Qeteshpony/displaytronic/flipdot board/README.md

Revere engineered from the original board. Some parts are simplified and just show the logic. 

This is NOT a complete schematics drawing.
