Qeteshpony/displaytronic/CHANGELOG.md

# Changelog

## [1.0.1](https://github.com/Qeteshpony/displaytronic/compare/v1.0.0...v1.0.1) (2026-11-11)

### Bug Fixes

* **pcb:** wrong part number for 2 resistors ([9722948](https://github.com/Qeteshpony/displaytronic/commit/9722948e23da16186d39c03120288686e7f75a20))

## 1.0.0 (2026-11-10)

### Features

* **firmware:** add debugging over UART ([d42d1d6](https://github.com/Qeteshpony/displaytronic/commit/d42d1d64cf81c9214dd820a91fe4b76d763d3ecf))
* **firmware:** add flipdot driver ([967017e](https://github.com/Qeteshpony/displaytronic/commit/967017ec6ec610487fccee4e81757cec2f1832d0))
* **firmware:** add watchdog ([05a6637](https://github.com/Qeteshpony/displaytronic/commit/05a66375ccd68013d24e9db8baa855eb8dae2f2b))
* **firmware:** i2c interface ([2d1449f](https://github.com/Qeteshpony/displaytronic/commit/2d1449f2643044d9899a1bcff528ac561d937caa))
* **firmware:** light control ([0a22b43](https://github.com/Qeteshpony/displaytronic/commit/0a22b433b96bafc5785d298e5330ff81d1ff8ec4))
* **firmware:** status led ([9a84e4e](https://github.com/Qeteshpony/displaytronic/commit/9a84e4e517a992f0ab90c25b8353c08e9bccb6c8))
* **firmware:** version variables ([1e22f5d](https://github.com/Qeteshpony/displaytronic/commit/1e22f5d5b68a2e35fe8b67fa83a54d46f8ed88af))
* **firmware:** voltage sensors ([f075a49](https://github.com/Qeteshpony/displaytronic/commit/f075a49cf83af12c4e1e7ecaf647c56542b67ade))
* **pcb:** add pulse length limiter ([4bc0cde](https://github.com/Qeteshpony/displaytronic/commit/4bc0cdea27e73a1a9573296e2052f03f9e7936c4))
* **pcb:** add test points for some measurements ([2fb60d9](https://github.com/Qeteshpony/displaytronic/commit/2fb60d90d1a6a19221fe2e596b67342964169248))

### Bug Fixes

* **firmware:** add line break after debug messages ([049d4a1](https://github.com/Qeteshpony/displaytronic/commit/049d4a1bdcdabd539bb84be48b84d3c564b92f33))
* **firmware:** missing check ([3f58c2e](https://github.com/Qeteshpony/displaytronic/commit/3f58c2e17abb0dd11ff050c7f13f776b6e84d881))
* **firmware:** wrong variable type ([972ce3d](https://github.com/Qeteshpony/displaytronic/commit/972ce3dc0bdc4f2c249ff911073fc927c013a0ef))
* **firmware:** wrong variable type ([5a82e2e](https://github.com/Qeteshpony/displaytronic/commit/5a82e2e93db4aff974e40ec310347f2e365a50d5))
* **pcb:** add flyback diodes to row drivers ([ad231c8](https://github.com/Qeteshpony/displaytronic/commit/ad231c836e0294169ef6a69e5529e9fcd01c4730))
* **pcb:** reduce high-side gate resistor values for faster switching ([8dd9e66](https://github.com/Qeteshpony/displaytronic/commit/8dd9e664ee31bba52ffd4d5f429f1cfb8b86b1ce))
