Qeteshpony/displaytronic/pcb/displaytronic.kicad_pcb

## KiCad design pcb/displaytronic.kicad_pcb (2026-11-11)

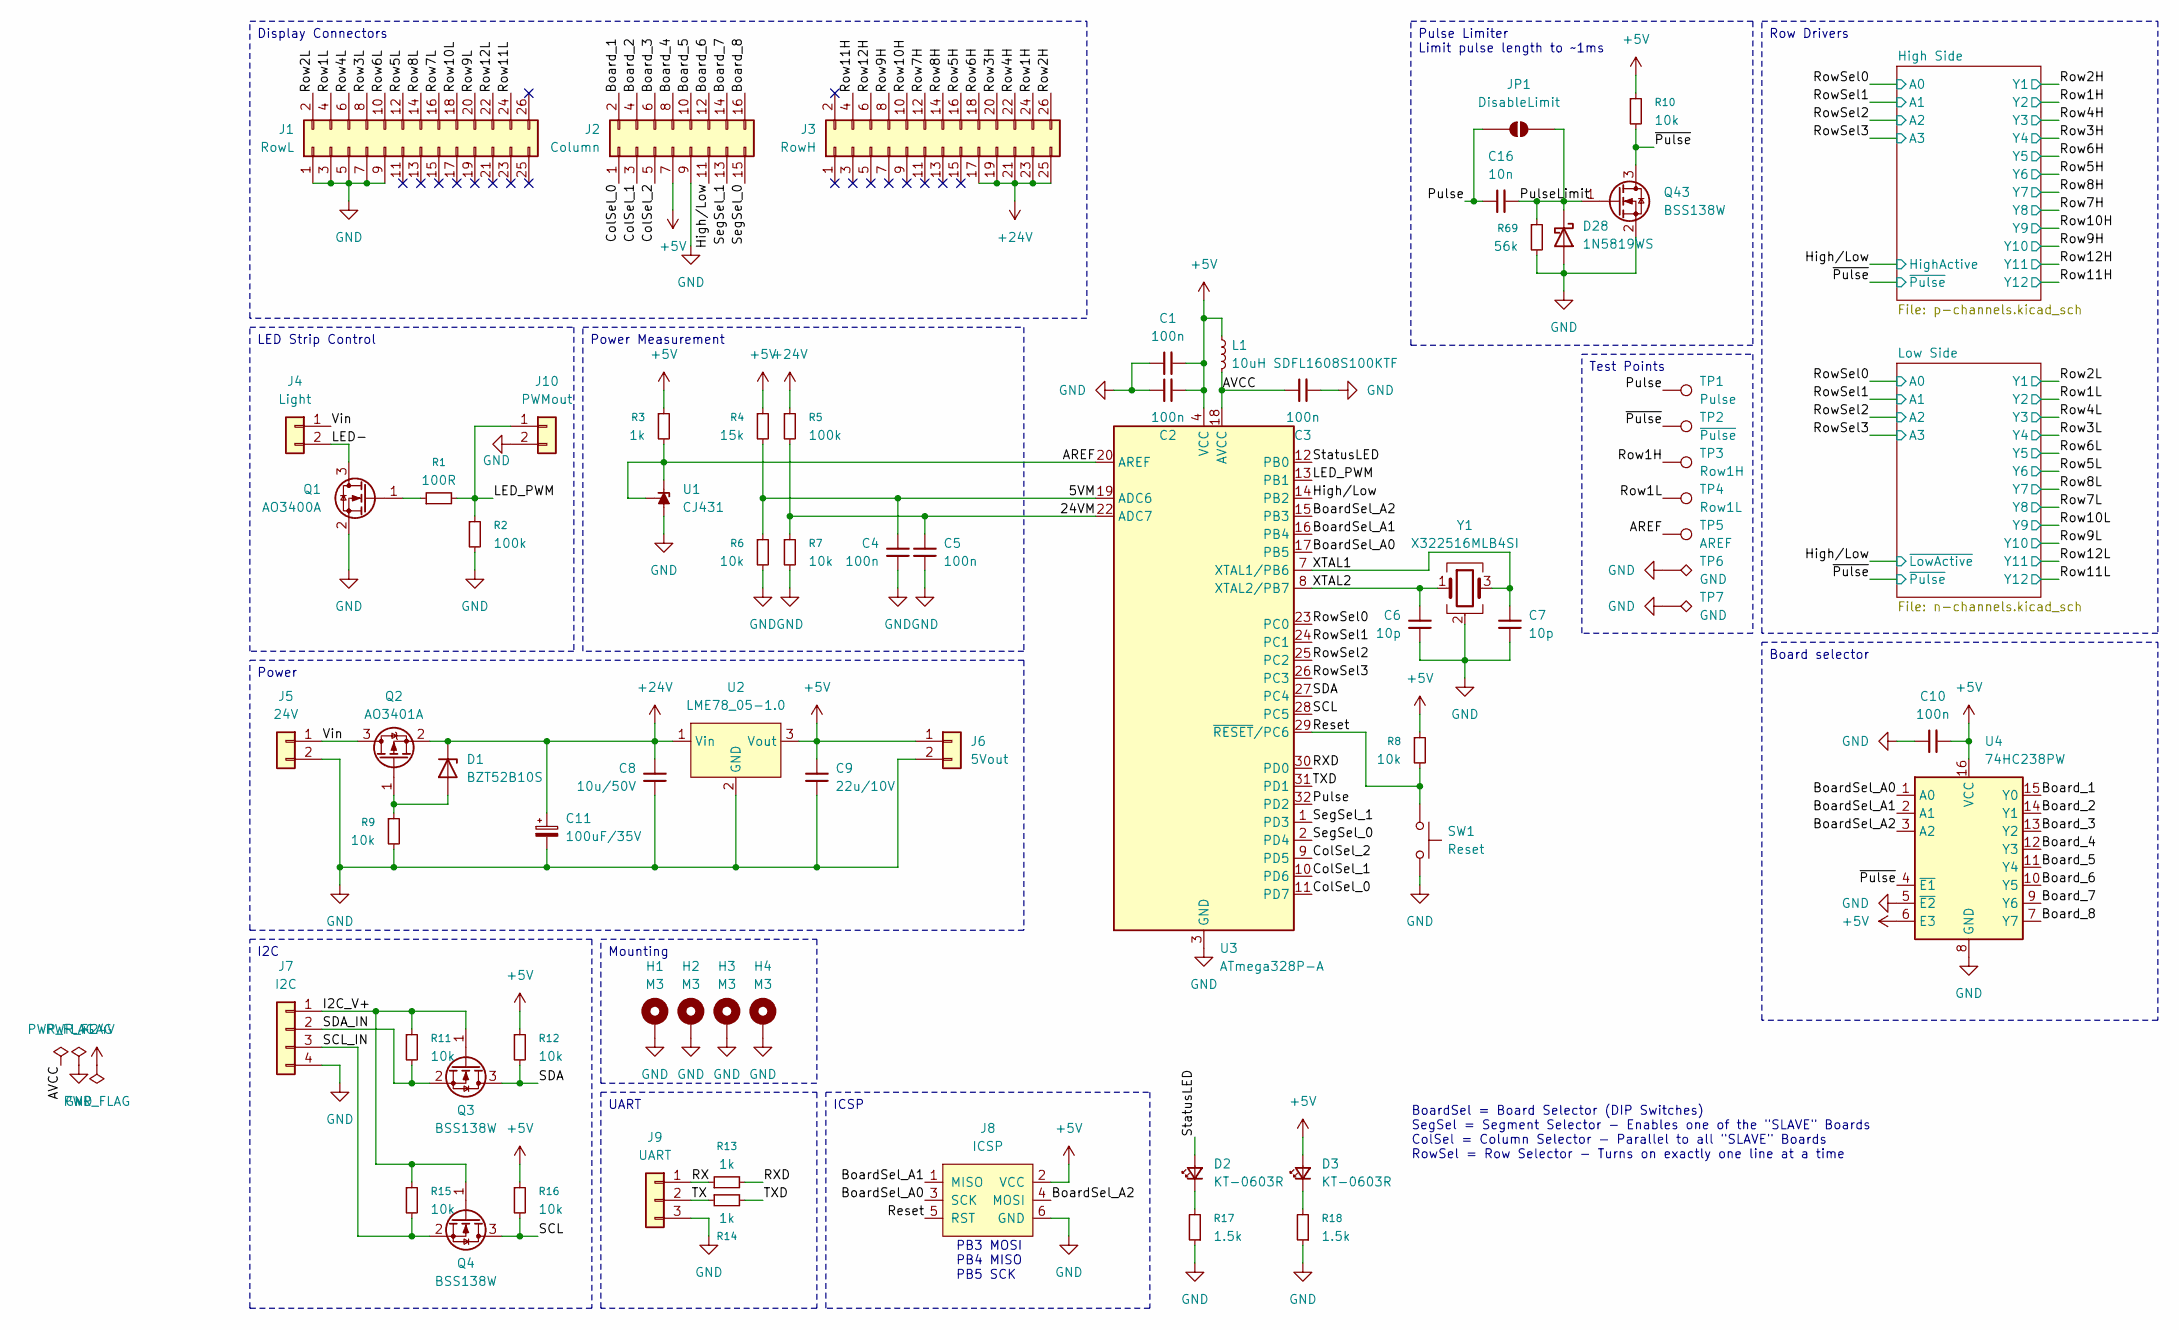
[picture p1: schematic displaytronic.kicad_sch]

Parts:
C1, C2, C3, C4, C5, C10: 100n; C_0402_1005Metric; LCSC C307331
C6, C7: 10p; C_0402_1005Metric; LCSC C32949
C8: 10u/50V; C_1206_3216Metric; LCSC C13585
C9: 22u/10V; C_1206_3216Metric; LCSC C12891
C11: 100uF/35V; CP_Radial_D8.0mm_P3.50mm
C16: 10n; C_0402_1005Metric; LCSC C15195
D1: BZT52B10S; D_SOD-323; LCSC C22399886
D2, D3: KT-0603R; LED_0603_1608Metric; LCSC C2286
D28: 1N5819WS; D_SOD-323; LCSC C191023
H1, H2, H3, H4: M3; MountingHole_3.2mm_M3_Pad
J1: RowL; IDC-Header_2x13_P2.54mm_Vertical
J2: Column; IDC-Header_2x08_P2.54mm_Vertical
J3: RowH; IDC-Header_2x13_P2.54mm_Vertical
J4: Light; CTB9352-2
J5: 24V; CTB9352-2
J6: 5Vout; JST_PH_B2B-PH-K_1x02_P2.00mm_Vertical
J7: I2C; JST_PH_B4B-PH-K_1x04_P2.00mm_Vertical
J8: ICSP; PinHeader_2x03_P2.54mm_Vertical
J9: UART; JST_PH_B3B-PH-K_1x03_P2.00mm_Vertical
J10: PWMout; JST_PH_B2B-PH-K_1x02_P2.00mm_Vertical
JP1: DisableLimit; SolderJumper-2_P1.3mm_Open_RoundedPad1.0x1.5mm
L1: 10uH SDFL1608S100KTF; L_0603_1608Metric; LCSC C1035
Q1: AO3400A; SOT-23; LCSC C20917
Q2: AO3401A; SOT-23; LCSC C15127
Q3, Q4, Q43: BSS138W; SOT-323_SC-70; LCSC C28646265
R1: 100R; R_0402_1005Metric; LCSC C25076
R2, R5: 100k; R_0402_1005Metric; LCSC C25741
R3, R13, R14: 1k; R_0402_1005Metric; LCSC C11702
R4: 15k; R_0402_1005Metric; LCSC C25756
R6, R7, R8, R9, R10, R11, R12, R15, R16: 10k; R_0402_1005Metric; LCSC C25744
R17, R18: 1.5k; R_0402_1005Metric; LCSC C25867
R69: 56k; R_0402_1005Metric; LCSC C25796
SW1: Reset; SW_Push_SPST_NO_Alps_SKRK; LCSC C720477
TP1: Pulse; TestPoint_Pad_D2.0mm
TP2: ~{Pulse}; TestPoint_Pad_D2.0mm
TP3: Row1H; TestPoint_Pad_D2.0mm
TP4: Row1L; TestPoint_Pad_D2.0mm
TP5: AREF; TestPoint_Pad_D2.0mm
TP6, TP7: GND; TestPoint_Pad_2.0x2.0mm
U1: CJ431; SOT-23; LCSC C3113
U2: LME78_05-1.0; LME78_1.0-Series
U3: ATmega328P-A; TQFP-32_7x7mm_P0.8mm; LCSC C14877
U4: 74HC238PW; TSSOP-16_4.4x5mm_P0.65mm; LCSC C60434
Y1: X322516MLB4SI; Crystal_SMD_3225-4Pin_3.2x2.5mm; LCSC C13738

Connections:
+5V: C1.2, C2.2, C9.2, C10.2, D3.2 (A), J2.7, J6.1, J8.2 (VCC), L1.1, R3.1, R4.1, R8.1, R10.1, R12.1, R16.1, U2.3 (Vout), U3.4 (VCC), U3.6 (VCC), U4.6 (E3), U4.16 (VCC); also elsewhere on the board
+24V: C8.2, C11.1, D1.1 (K), J3.17, J3.19, J3.21, J3.23, J3.25, Q2.2 (S), R5.1, U2.1 (Vin); also elsewhere on the board
/5VM: C4.2, R4.2, R6.1, U3.19 (ADC6)
/24VM: C5.2, R5.2, R7.1, U3.22 (ADC7)
/AREF: R3.2, TP5.1 (1_1), U1.1 (K), U1.2 (REF), U3.20 (AREF)
/AVCC: C3.2, L1.2, U3.18 (AVCC)
/BoardSel_A0: J8.3 (SCK), U3.17 (PB5), U4.1 (A0)
/BoardSel_A1: J8.1 (MISO), U3.16 (PB4), U4.2 (A1)
/BoardSel_A2: J8.4 (MOSI), U3.15 (PB3), U4.3 (A2)
/Board_1: J2.2, U4.15 (Y0)
/Board_2: J2.4, U4.14 (Y1)
/Board_3: J2.6, U4.13 (Y2)
/Board_4: J2.8, U4.12 (Y3)
/Board_5: J2.10, U4.11 (Y4)
/Board_6: J2.12, U4.10 (Y5)
/Board_7: J2.14, U4.9 (Y6)
/Board_8: J2.16, U4.7 (Y7)
/ColSel_0: J2.1, U3.11 (PD7)
/ColSel_1: J2.3, U3.10 (PD6)
/ColSel_2: J2.5, U3.9 (PD5)
/High/Low: J2.11, U3.14 (PB2); also elsewhere on the board
/I2C_V+: J7.1, Q3.1 (G), Q4.1 (G), R11.1, R15.1
/LED-: J4.2, Q1.3 (D)
/LED_PWM: J10.1, R1.2, R2.1, U3.13 (PB1)
/Pulse: C16.2, JP1.1 (A), TP1.1 (1_1), U3.32 (PD2)
/PulseLimit: C16.1, D28.1 (K), JP1.2 (B), Q43.1 (G), R69.1
/RX: J9.1, R13.1
/RXD: R13.2, U3.30 (PD0)
/Reset: J8.5 (RST), R8.2, SW1.1, U3.29 (~RESET/PC6)
/Row1H: J3.24, TP3.1 (1_1); also elsewhere on the board
/Row1L: J1.4, TP4.1 (1_1); also elsewhere on the board
/Row2H: J3.26; also elsewhere on the board
/Row2L: J1.2; also elsewhere on the board
/Row3H: J3.20; also elsewhere on the board
/Row3L: J1.8; also elsewhere on the board
/Row4H: J3.22; also elsewhere on the board
/Row4L: J1.6; also elsewhere on the board
/Row5H: J3.16; also elsewhere on the board
/Row5L: J1.12; also elsewhere on the board
/Row6H: J3.18; also elsewhere on the board
/Row6L: J1.10; also elsewhere on the board
/Row7H: J3.12; also elsewhere on the board
/Row7L: J1.16; also elsewhere on the board
/Row8H: J3.14; also elsewhere on the board
/Row8L: J1.14; also elsewhere on the board
/Row9H: J3.8; also elsewhere on the board
/Row9L: J1.20; also elsewhere on the board
/Row10H: J3.10; also elsewhere on the board
/Row10L: J1.18; also elsewhere on the board
/Row11H: J3.4; also elsewhere on the board
/Row11L: J1.24; also elsewhere on the board
/Row12H: J3.6; also elsewhere on the board
/Row12L: J1.22; also elsewhere on the board
/RowSel0: U3.23 (PC0); also elsewhere on the board
/RowSel1: U3.24 (PC1); also elsewhere on the board
/RowSel2: U3.25 (PC2); also elsewhere on the board
/RowSel3: U3.26 (PC3); also elsewhere on the board
/SCL: Q4.3 (D), R16.2, U3.28 (PC5)
/SCL_IN: J7.3, Q4.2 (S), R15.2
/SDA: Q3.3 (D), R12.2, U3.27 (PC4)
/SDA_IN: J7.2, Q3.2 (S), R11.2
/SegSel_0: J2.15, U3.2 (PD4)
/SegSel_1: J2.13, U3.1 (PD3)
/StatusLED: D2.2 (A), U3.12 (PB0)
/TX: J9.2, R14.1
/TXD: R14.2, U3.31 (PD1)
/Vin: J4.1, J5.1, Q2.3 (D)
/XTAL1: C7.2, U3.7 (XTAL1/PB6), Y1.3
/XTAL2: C6.2, U3.8 (XTAL2/PB7), Y1.1
/~Pulse: Q43.3 (D), R10.2, TP2.1 (1_1), U4.4 (~E1); also elsewhere on the board
GND: C1.1, C2.1, C3.1, C4.1, C5.1, C6.1, C7.1, C8.1, C9.1, C10.1, C11.2, D28.2 (A), H1.1 (1_1), H2.1 (1_1), H3.1 (1_1), H4.1 (1_1), J1.1, J1.3, J1.5, J1.7, J1.9, J2.9, J5.2, J6.2, J7.4, J8.6 (GND), J9.3, J10.2, Q1.2 (S), Q43.2 (S), R2.2, R6.2, R7.2, R9.2, R17.1, R18.1, R69.2, SW1.2, TP6.1 (1_1), TP7.1 (1_1), U1.3 (A), U2.2 (GND), U3.3 (GND), U3.5 (GND), U3.21 (GND), U4.5 (~E2), U4.8 (GND), Y1.2 (G), Y1.4 (G); also elsewhere on the board
unnamed: D1.2 (A), Q2.1 (G), R9.1
unnamed: D2.1 (K), R17.2
unnamed: D3.1 (K), R18.2
unnamed: Q1.1 (G), R1.1

Notes on the sheet:
PB3 MOSI PB4 MISO PB5 SCK
BoardSel = Board Selector (DIP Switches) SegSel = Segment Selector - Enables one of the "SLAVE" Boards ColSel = Column Selector - Parallel to all "SLAVE" Boards RowSel = Row Selector - Turns on exactly one line at a time
Mounting
Board selector
ICSP
UART
Power Measurement
LED Strip Control
I2C
Pulse Limiter Limit pulse length to ~1ms
Row Drivers
Power
Test Points
Display Connectors

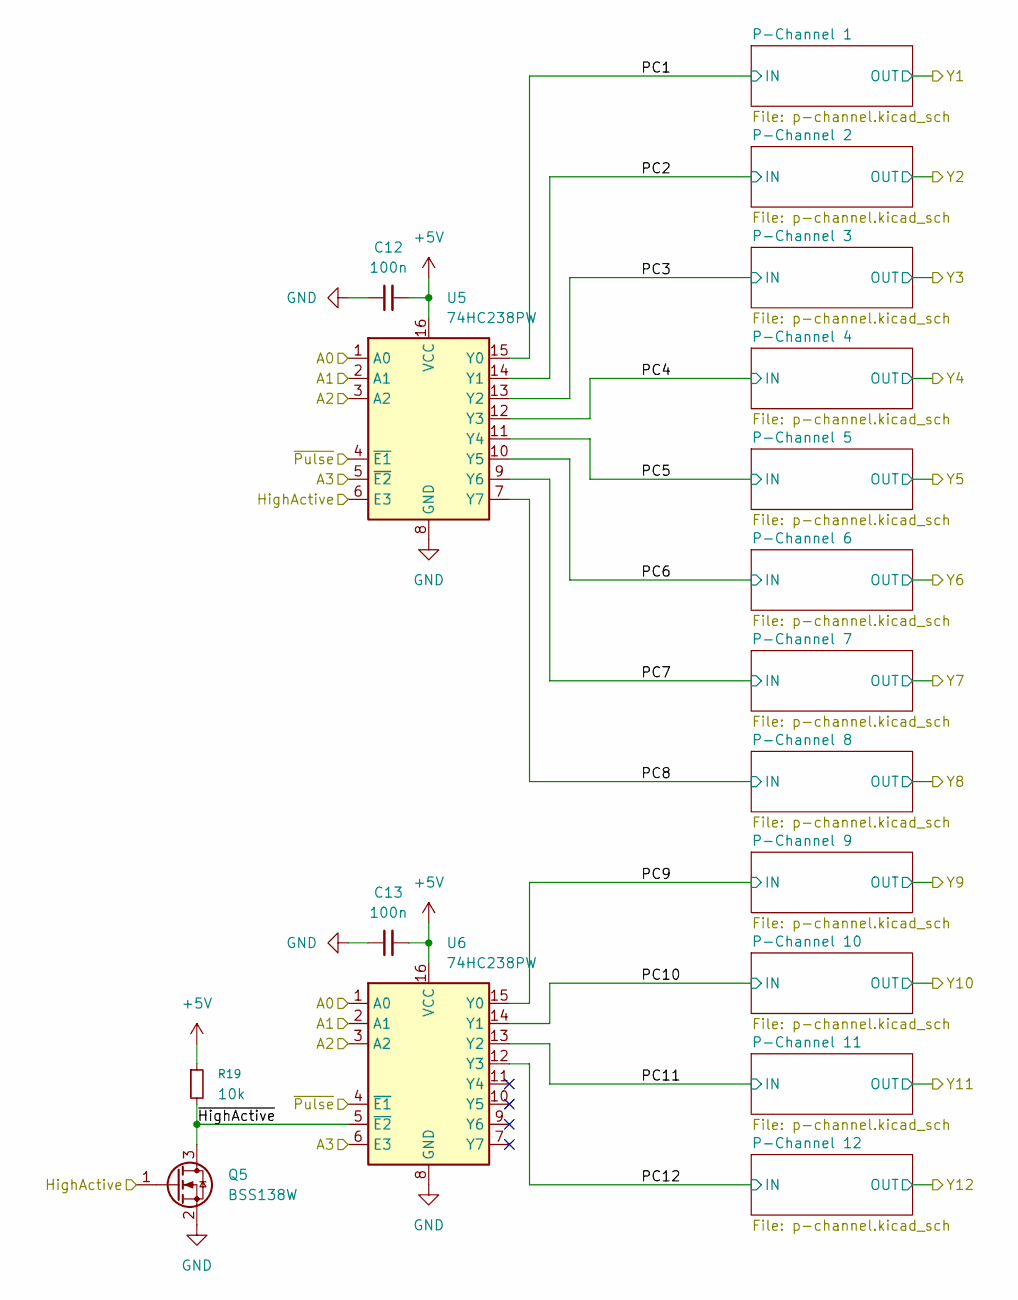
[picture p2: schematic p-channels.kicad_sch]

Parts:
C12, C13: 100n; C_0402_1005Metric; LCSC C307331
Q5: BSS138W; SOT-323_SC-70; LCSC C28646265
R19: 10k; R_0402_1005Metric; LCSC C25744
U5, U6: 74HC238PW; TSSOP-16_4.4x5mm_P0.65mm; LCSC C60434

Connections:
+5V: C12.2, C13.2, R19.1, U5.16 (VCC), U6.16 (VCC); also elsewhere on the board
/High Side/PC1: U5.15 (Y0); also elsewhere on the board
/High Side/PC2: U5.14 (Y1); also elsewhere on the board
/High Side/PC3: U5.13 (Y2); also elsewhere on the board
/High Side/PC4: U5.12 (Y3); also elsewhere on the board
/High Side/PC5: U5.11 (Y4); also elsewhere on the board
/High Side/PC6: U5.10 (Y5); also elsewhere on the board
/High Side/PC7: U5.9 (Y6); also elsewhere on the board
/High Side/PC8: U5.7 (Y7); also elsewhere on the board
/High Side/PC9: U6.15 (Y0); also elsewhere on the board
/High Side/PC10: U6.14 (Y1); also elsewhere on the board
/High Side/PC11: U6.13 (Y2); also elsewhere on the board
/High Side/PC12: U6.12 (Y3); also elsewhere on the board
/High Side/~HighActive: Q5.3 (D), R19.2, U6.5 (~E2)
/High/Low: Q5.1 (G), U5.6 (E3); also elsewhere on the board
/RowSel0: U5.1 (A0), U6.1 (A0); also elsewhere on the board
/RowSel1: U5.2 (A1), U6.2 (A1); also elsewhere on the board
/RowSel2: U5.3 (A2), U6.3 (A2); also elsewhere on the board
/RowSel3: U5.5 (~E2), U6.6 (E3); also elsewhere on the board
/~Pulse: U5.4 (~E1), U6.4 (~E1); also elsewhere on the board
GND: C12.1, C13.1, Q5.2 (S), U5.8 (GND), U6.8 (GND); also elsewhere on the board

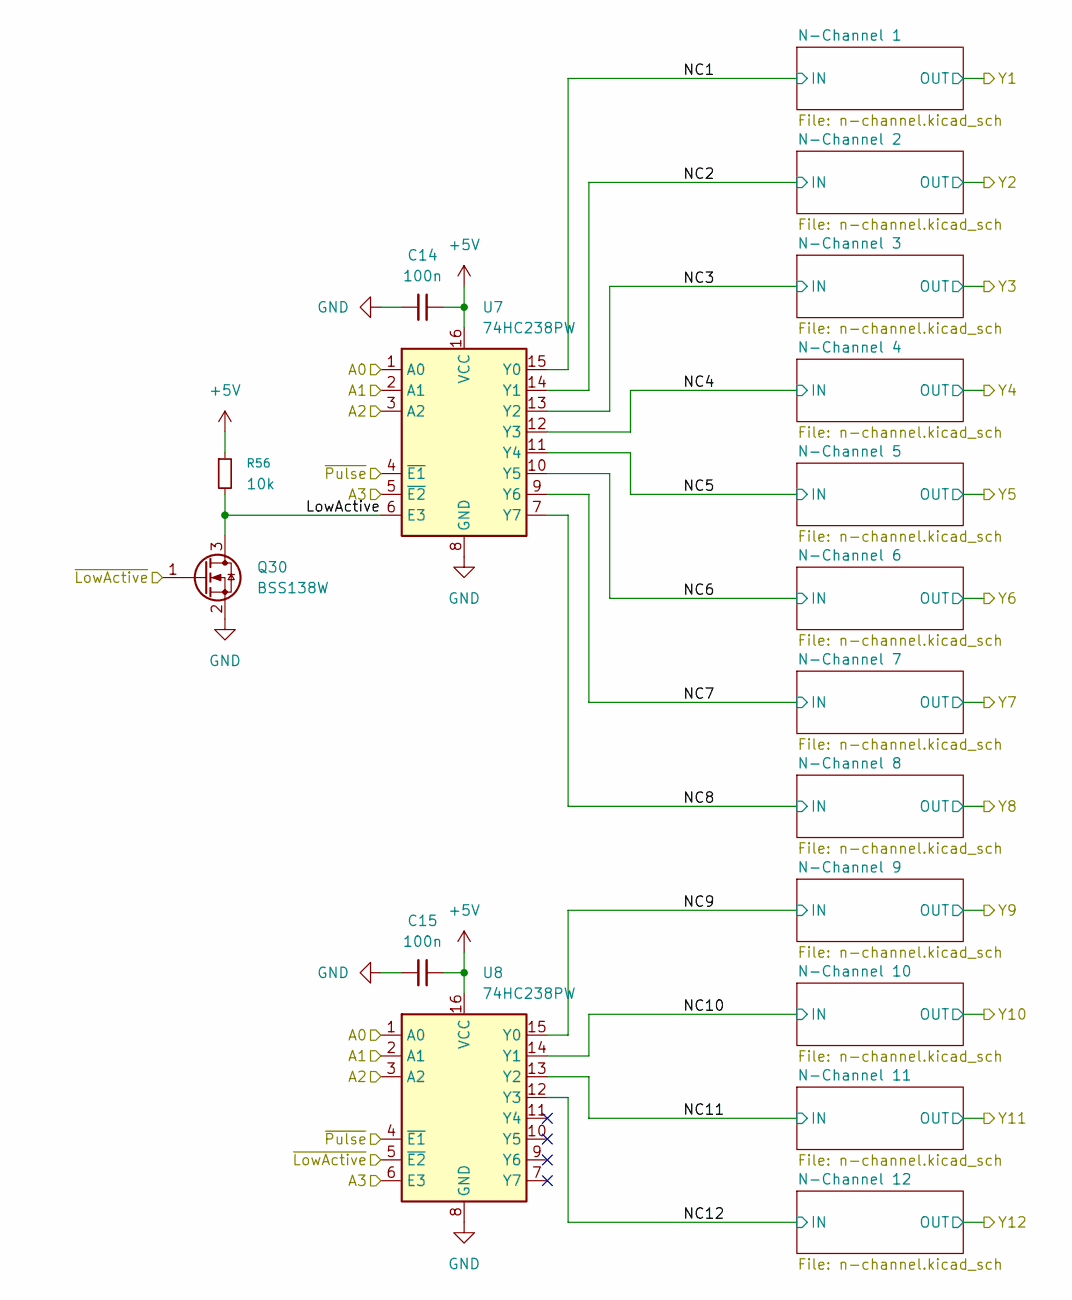
[picture p3: schematic n-channels.kicad_sch]

Parts:
C14, C15: 100n; C_0402_1005Metric; LCSC C307331
Q30: BSS138W; SOT-323_SC-70; LCSC C28646265
R56: 10k; R_0402_1005Metric; LCSC C25744
U7, U8: 74HC238PW; TSSOP-16_4.4x5mm_P0.65mm; LCSC C60434

Connections:
+5V: C14.2, C15.2, R56.1, U7.16 (VCC), U8.16 (VCC); also elsewhere on the board
/High/Low: Q30.1 (G), U8.5 (~E2); also elsewhere on the board
/Low Side/LowActive: Q30.3 (D), R56.2, U7.6 (E3)
/Low Side/NC1: U7.15 (Y0); also elsewhere on the board
/Low Side/NC2: U7.14 (Y1); also elsewhere on the board
/Low Side/NC3: U7.13 (Y2); also elsewhere on the board
/Low Side/NC4: U7.12 (Y3); also elsewhere on the board
/Low Side/NC5: U7.11 (Y4); also elsewhere on the board
/Low Side/NC6: U7.10 (Y5); also elsewhere on the board
/Low Side/NC7: U7.9 (Y6); also elsewhere on the board
/Low Side/NC8: U7.7 (Y7); also elsewhere on the board
/Low Side/NC9: U8.15 (Y0); also elsewhere on the board
/Low Side/NC10: U8.14 (Y1); also elsewhere on the board
/Low Side/NC11: U8.13 (Y2); also elsewhere on the board
/Low Side/NC12: U8.12 (Y3); also elsewhere on the board
/RowSel0: U7.1 (A0), U8.1 (A0); also elsewhere on the board
/RowSel1: U7.2 (A1), U8.2 (A1); also elsewhere on the board
/RowSel2: U7.3 (A2), U8.3 (A2); also elsewhere on the board
/RowSel3: U7.5 (~E2), U8.6 (E3); also elsewhere on the board
/~Pulse: U7.4 (~E1), U8.4 (~E1); also elsewhere on the board
GND: C14.1, C15.1, Q30.2 (S), U7.8 (GND), U8.8 (GND); also elsewhere on the board

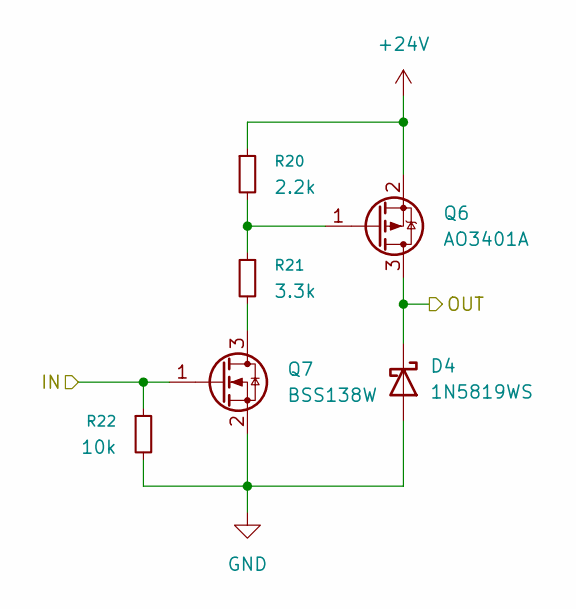
[picture p4: schematic p-channel.kicad_sch]

Parts:
D4: 1N5819WS; D_SOD-323; LCSC C191023
Q6: AO3401A; SOT-23; LCSC C15127
Q7: BSS138W; SOT-323_SC-70; LCSC C28646265
R20: 2.2k; R_0402_1005Metric; LCSC C25879
R21: 3.3k; R_0402_1005Metric; LCSC C25890
R22: 10k; R_0402_1005Metric; LCSC C25744

Connections:
+24V: Q6.2 (S), R20.1; also elsewhere on the board
/High Side/PC1: Q7.1 (G), R22.1; also elsewhere on the board
/Row2H: D4.1 (K), Q6.3 (D); also elsewhere on the board
GND: D4.2 (A), Q7.2 (S), R22.2; also elsewhere on the board
unnamed: Q6.1 (G), R20.2, R21.1
unnamed: Q7.3 (D), R21.2

Parts of its further copies:
D5, D6, D7, D8, D9, D10, D11, D12, D13, D14, D15: 1N5819WS; D_SOD-323; LCSC C191023
Q8, Q10, Q12, Q14, Q16, Q18, Q20, Q22, Q24, Q26, Q28: AO3401A; SOT-23; LCSC C15127
Q9, Q11, Q13, Q15, Q17, Q19, Q21, Q23, Q25, Q27, Q29: BSS138W; SOT-323_SC-70; LCSC C28646265
R23, R26, R29, R32, R35, R38, R41, R44, R47, R50, R53: 2.2k; R_0402_1005Metric; LCSC C25879
R24, R27, R30, R33, R36, R39, R42, R45, R48, R51, R54: 3.3k; R_0402_1005Metric; LCSC C25890
R25, R28, R31, R34, R37, R40, R43, R46, R49, R52, R55: 10k; R_0402_1005Metric; LCSC C25744

Connections of its further copies:
+24V: Q8.2 (S), Q10.2 (S), Q12.2 (S), Q14.2 (S), Q16.2 (S), Q18.2 (S), Q20.2 (S), Q22.2 (S), Q24.2 (S), Q26.2 (S), Q28.2 (S), R23.1, R26.1, R29.1, R32.1, R35.1, R38.1, R41.1, R44.1, R47.1, R50.1, R53.1; also elsewhere on the board
/High Side/PC2: Q9.1 (G), R25.1; also elsewhere on the board
/High Side/PC3: Q11.1 (G), R28.1; also elsewhere on the board
/High Side/PC4: Q13.1 (G), R31.1; also elsewhere on the board
/High Side/PC5: Q15.1 (G), R34.1; also elsewhere on the board
/High Side/PC6: Q17.1 (G), R37.1; also elsewhere on the board
/High Side/PC7: Q19.1 (G), R40.1; also elsewhere on the board
/High Side/PC8: Q21.1 (G), R43.1; also elsewhere on the board
/High Side/PC9: Q23.1 (G), R46.1; also elsewhere on the board
/High Side/PC10: Q25.1 (G), R49.1; also elsewhere on the board
/High Side/PC11: Q27.1 (G), R52.1; also elsewhere on the board
/High Side/PC12: Q29.1 (G), R55.1; also elsewhere on the board
/Row1H: D5.1 (K), Q8.3 (D); also elsewhere on the board
/Row3H: D7.1 (K), Q12.3 (D); also elsewhere on the board
/Row4H: D6.1 (K), Q10.3 (D); also elsewhere on the board
/Row5H: D9.1 (K), Q16.3 (D); also elsewhere on the board
/Row6H: D8.1 (K), Q14.3 (D); also elsewhere on the board
/Row7H: D11.1 (K), Q20.3 (D); also elsewhere on the board
/Row8H: D10.1 (K), Q18.3 (D); also elsewhere on the board
/Row9H: D13.1 (K), Q24.3 (D); also elsewhere on the board
/Row10H: D12.1 (K), Q22.3 (D); also elsewhere on the board
/Row11H: D15.1 (K), Q28.3 (D); also elsewhere on the board
/Row12H: D14.1 (K), Q26.3 (D); also elsewhere on the board
GND: D5.2 (A), D6.2 (A), D7.2 (A), D8.2 (A), D9.2 (A), D10.2 (A), D11.2 (A), D12.2 (A), D13.2 (A), D14.2 (A), D15.2 (A), Q9.2 (S), Q11.2 (S), Q13.2 (S), Q15.2 (S), Q17.2 (S), Q19.2 (S), Q21.2 (S), Q23.2 (S), Q25.2 (S), Q27.2 (S), Q29.2 (S), R25.2, R28.2, R31.2, R34.2, R37.2, R40.2, R43.2, R46.2, R49.2, R52.2, R55.2; also elsewhere on the board
unnamed: Q8.1 (G), R23.2, R24.1
unnamed: Q9.3 (D), R24.2
unnamed: Q10.1 (G), R26.2, R27.1
unnamed: Q11.3 (D), R27.2
unnamed: Q12.1 (G), R29.2, R30.1
unnamed: Q13.3 (D), R30.2
unnamed: Q14.1 (G), R32.2, R33.1
unnamed: Q15.3 (D), R33.2
unnamed: Q16.1 (G), R35.2, R36.1
unnamed: Q17.3 (D), R36.2
unnamed: Q18.1 (G), R38.2, R39.1
unnamed: Q19.3 (D), R39.2
unnamed: Q20.1 (G), R41.2, R42.1
unnamed: Q21.3 (D), R42.2
unnamed: Q22.1 (G), R44.2, R45.1
unnamed: Q23.3 (D), R45.2
unnamed: Q24.1 (G), R47.2, R48.1
unnamed: Q25.3 (D), R48.2
unnamed: Q26.1 (G), R50.2, R51.1
unnamed: Q27.3 (D), R51.2
unnamed: Q28.1 (G), R53.2, R54.1
unnamed: Q29.3 (D), R54.2

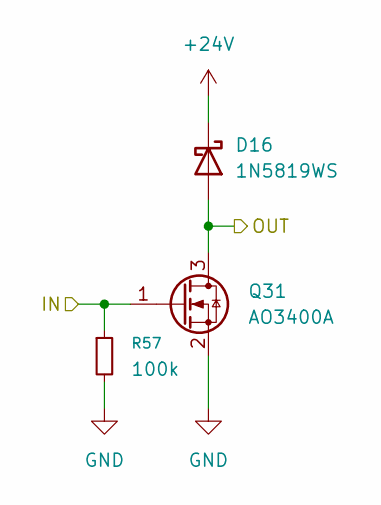
[picture p5: schematic n-channel.kicad_sch]

Parts:
D16: 1N5819WS; D_SOD-323; LCSC C191023
Q31: AO3400A; SOT-23; LCSC C20917
R57: 100k; R_0402_1005Metric; LCSC C25741

Connections:
+24V: D16.1 (K); also elsewhere on the board
/Low Side/NC1: Q31.1 (G), R57.1; also elsewhere on the board
/Row2L: D16.2 (A), Q31.3 (D); also elsewhere on the board
GND: Q31.2 (S), R57.2; also elsewhere on the board

Parts of its further copies:
D17, D18, D19, D20, D21, D22, D23, D24, D25, D26, D27: 1N5819WS; D_SOD-323; LCSC C191023
Q32, Q33, Q34, Q35, Q36, Q37, Q38, Q39, Q40, Q41, Q42: AO3400A; SOT-23; LCSC C20917
R58, R59, R60, R61, R62, R63, R64, R65, R66, R67, R68: 100k; R_0402_1005Metric; LCSC C25741

Connections of its further copies:
+24V: D17.1 (K), D18.1 (K), D19.1 (K), D20.1 (K), D21.1 (K), D22.1 (K), D23.1 (K), D24.1 (K), D25.1 (K), D26.1 (K), D27.1 (K); also elsewhere on the board
/Low Side/NC2: Q32.1 (G), R58.1; also elsewhere on the board
/Low Side/NC3: Q33.1 (G), R59.1; also elsewhere on the board
/Low Side/NC4: Q34.1 (G), R60.1; also elsewhere on the board
/Low Side/NC5: Q35.1 (G), R61.1; also elsewhere on the board
/Low Side/NC6: Q36.1 (G), R62.1; also elsewhere on the board
/Low Side/NC7: Q37.1 (G), R63.1; also elsewhere on the board
/Low Side/NC8: Q38.1 (G), R64.1; also elsewhere on the board
/Low Side/NC9: Q39.1 (G), R65.1; also elsewhere on the board
/Low Side/NC10: Q40.1 (G), R66.1; also elsewhere on the board
/Low Side/NC11: Q41.1 (G), R67.1; also elsewhere on the board
/Low Side/NC12: Q42.1 (G), R68.1; also elsewhere on the board
/Row1L: D17.2 (A), Q32.3 (D); also elsewhere on the board
/Row3L: D19.2 (A), Q34.3 (D); also elsewhere on the board
/Row4L: D18.2 (A), Q33.3 (D); also elsewhere on the board
/Row5L: D21.2 (A), Q36.3 (D); also elsewhere on the board
/Row6L: D20.2 (A), Q35.3 (D); also elsewhere on the board
/Row7L: D23.2 (A), Q38.3 (D); also elsewhere on the board
/Row8L: D22.2 (A), Q37.3 (D); also elsewhere on the board
/Row9L: D25.2 (A), Q40.3 (D); also elsewhere on the board
/Row10L: D24.2 (A), Q39.3 (D); also elsewhere on the board
/Row11L: D27.2 (A), Q42.3 (D); also elsewhere on the board
/Row12L: D26.2 (A), Q41.3 (D); also elsewhere on the board
GND: Q32.2 (S), Q33.2 (S), Q34.2 (S), Q35.2 (S), Q36.2 (S), Q37.2 (S), Q38.2 (S), Q39.2 (S), Q40.2 (S), Q41.2 (S), Q42.2 (S), R58.2, R59.2, R60.2, R61.2, R62.2, R63.2, R64.2, R65.2, R66.2, R67.2, R68.2; also elsewhere on the board

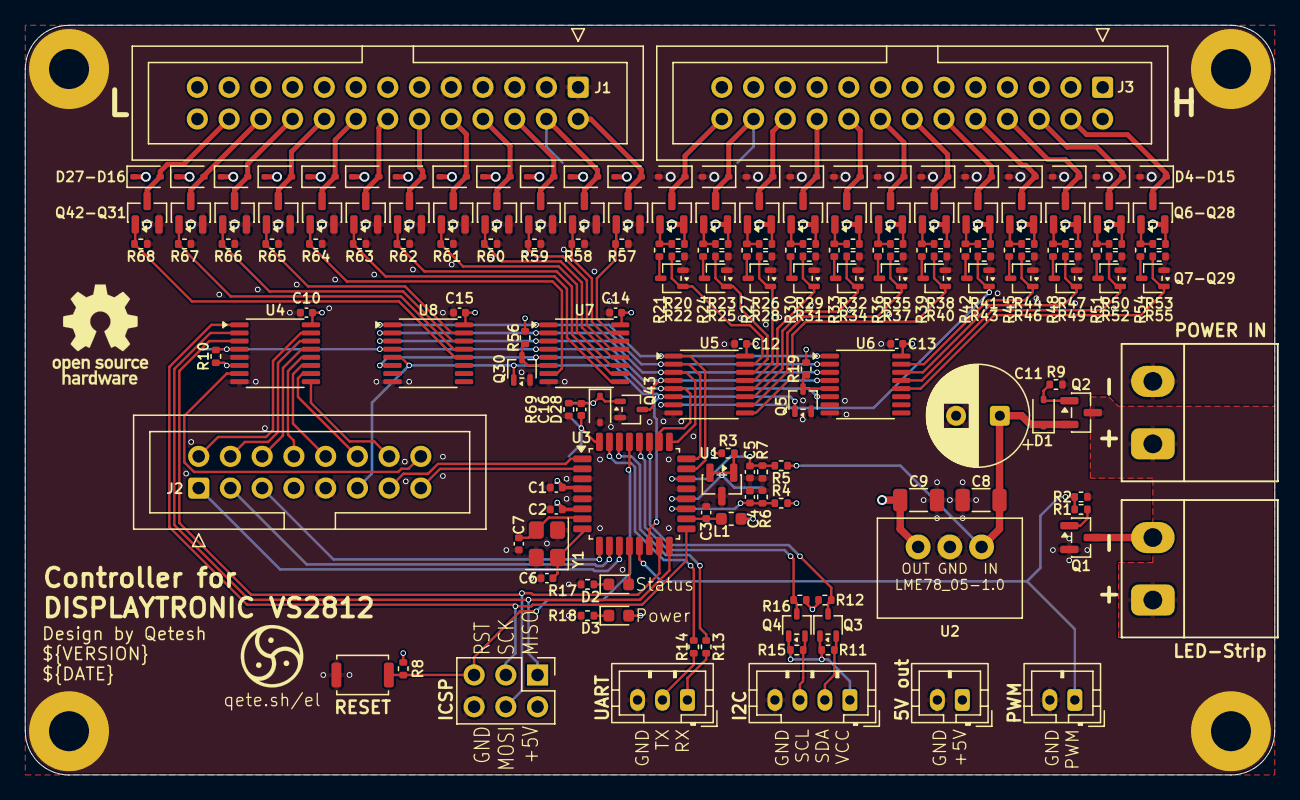
[picture p6: board displaytronic.kicad_pcb from above]

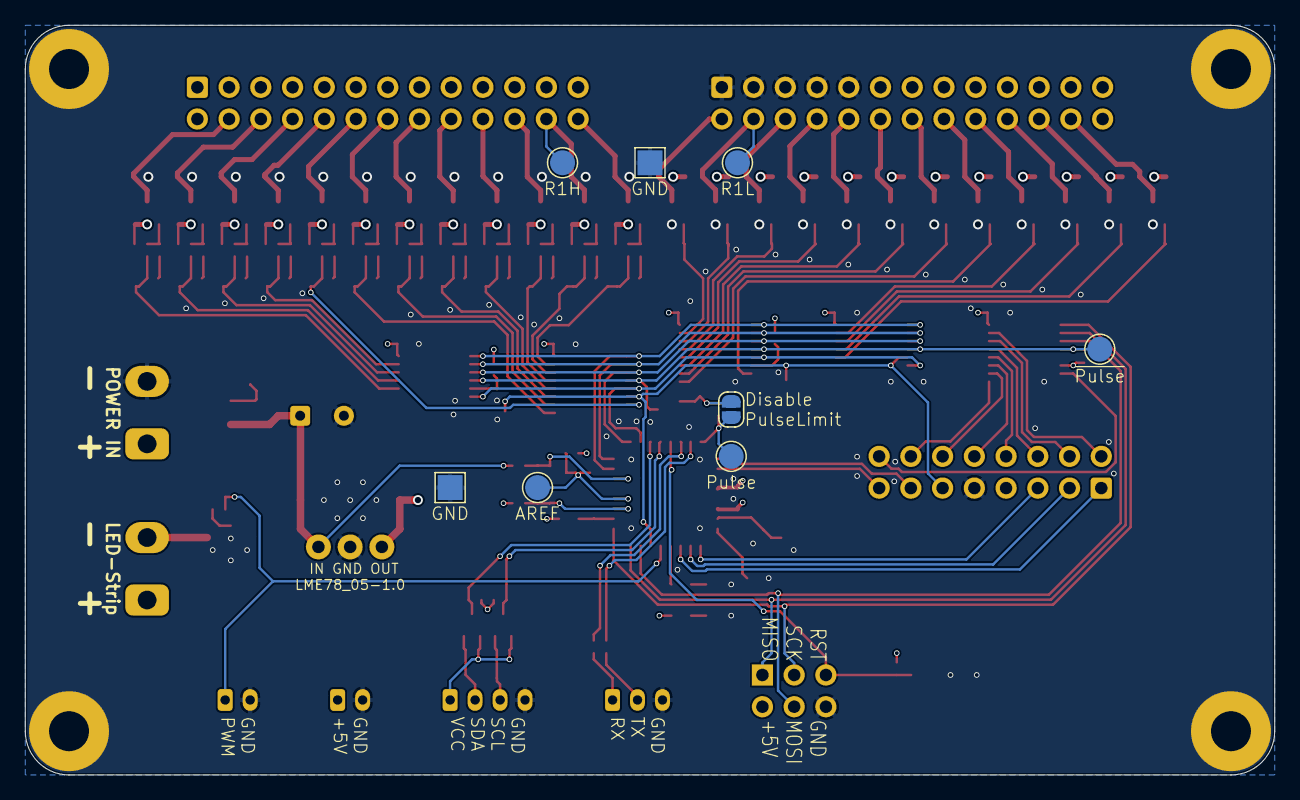
[picture p7: board displaytronic.kicad_pcb from below]

Board: 4 copper layers, 100.0 x 60.0 mm, 189 parts (8 on the bottom side), 125 nets.
