Qeteshpony/displaytronic/(commit log)

2026-11-06 docs: move reverse engineered files out of pcb dir
    [flipdot board.kicad_pcb, flipdot board.kicad_sch, slave.kicad_sch]
2026-11-07 docs: add details to reverse engineered schematics
    [flipdot board.kicad_sch]
2026-11-08 style(pcb): add blocks to the schematics for better readability
    [displaytronic.kicad_sch]
2026-11-08 fix(pcb): add flyback diodes to row drivers
    [displaytronic.kicad_pcb, n-channel.kicad_sch, n-channels.kicad_sch, p-channel.kicad_sch, p-channels.kicad_sch]
2026-11-08 feat(pcb): add pulse length limiter
    [displaytronic.kicad_pcb, displaytronic.kicad_sch]
2026-11-08 style(pcb): switch part positions for easier changing
    put R69 in a more reachable position in case it needs to be changed to a different value
    [displaytronic.kicad_pcb]
2026-11-08 feat(firmware): add flipdot driver
    [flipdot.cpp, flipdot.h, main.cpp, pin_init.cpp, pins.h]
2026-11-08 feat(firmware): add debugging over UART
2026-11-08 feat(firmware): status led
2026-11-09 style(pcb): clean up everything and prepare for production run
    [displaytronic.kicad_pcb, displaytronic.kicad_sch, n-channel.kicad_sch, p-channel.kicad_sch]
2026-11-10 feat(firmware): voltage sensors
2026-11-10 feat(firmware): i2c interface
2026-11-10 fix(firmware): wrong variable type
    [main.cpp]
2026-11-10 fix(firmware): add line break after debug messages
    [debug.h]
2026-11-10 ci(firmware): attach firmware hex to releases
2026-11-10 fix(pcb): reduce high-side gate resistor values for faster switching
    [displaytronic.kicad_pcb, p-channel.kicad_sch]
2026-11-10 feat(pcb): add test points for some measurements
    [displaytronic.kicad_pcb, displaytronic.kicad_sch]
2026-11-10 style(pcb): proper testpoint naming
    [displaytronic.kicad_pcb, displaytronic.kicad_sch]
2026-11-11 fix(pcb): wrong part number for 2 resistors
    [displaytronic.kicad_pcb, displaytronic.kicad_sch]
